eleciawhite/FeedThing/hardware/boostResistorRemoval.jpg

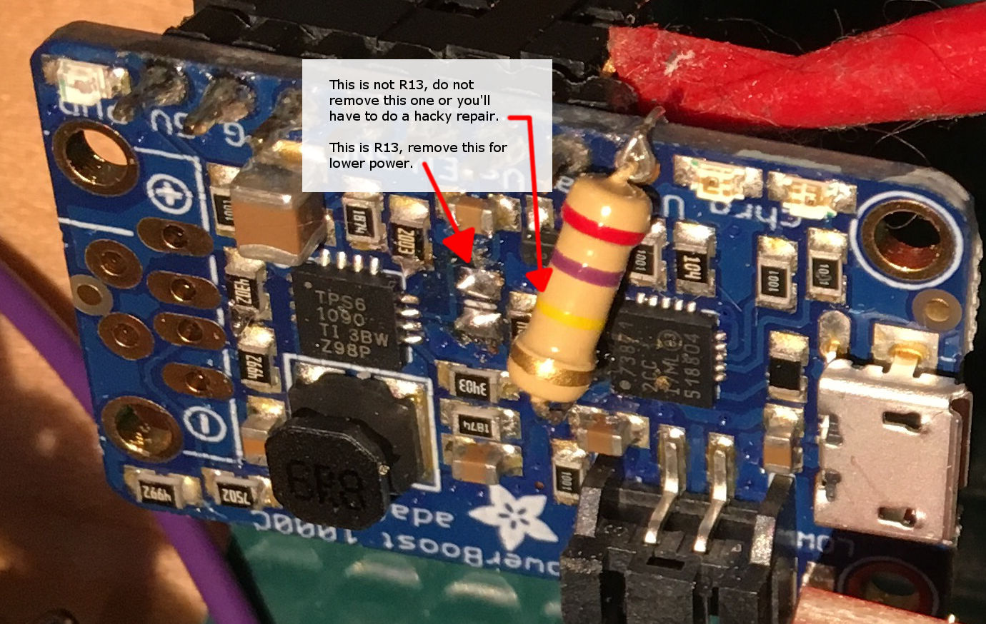
hardware/boostResistorRemoval.jpg
