eleciawhite/FeedThing/hardware/bom.xlsx

Item | Vendor | Price | Notes | Link
Thing | Sparkfun | $16 |  | https://www.sparkfun.com/products/13231
Photo interrupter | Sparkfun | $2 |  | https://www.sparkfun.com/products/9299
Photo interrupter board | Sparkfun | $1.50 | The resistor needs to be 1k as we are using a 3.3V power source | https://www.sparkfun.com/products/9322
Power boost | Adafruit | $20 | The 500C version also works, probably should switch to it | https://www.adafruit.com/products/2465
Motor board (Arduino v2) | Adafruit | $20 | This must be in switch to 3V mode | https://www.adafruit.com/product/1438
Motor | Adafruit | $5 |  | https://www.adafruit.com/products/858
LiPo battery | Adafruit | $29.50 | 6600mAh | https://www.adafruit.com/products/353
NPN BJT transistor | Sparkfun | $0.50 |  | https://www.sparkfun.com/products/521
10k Resistors | Sparkfun | $0.95 | This is a pack of all 10ks, anything large-ish and matched is fine. | https://www.sparkfun.com/products/11508
1k Resistor | Sparkfun | $0.25 | This is a single 1k, could do better to buy an assorted pack. | https://www.sparkfun.com/products/8980
Note: I'm not listing the header pins or jumper wires here, you may need some if you don't already have a pack
Not yet integrated but likely needed:
Power button | Adafruit | $5 |  | https://www.adafruit.com/products/482
