eleciawhite/FeedThing/hardware/FeedThingWiring.jpg

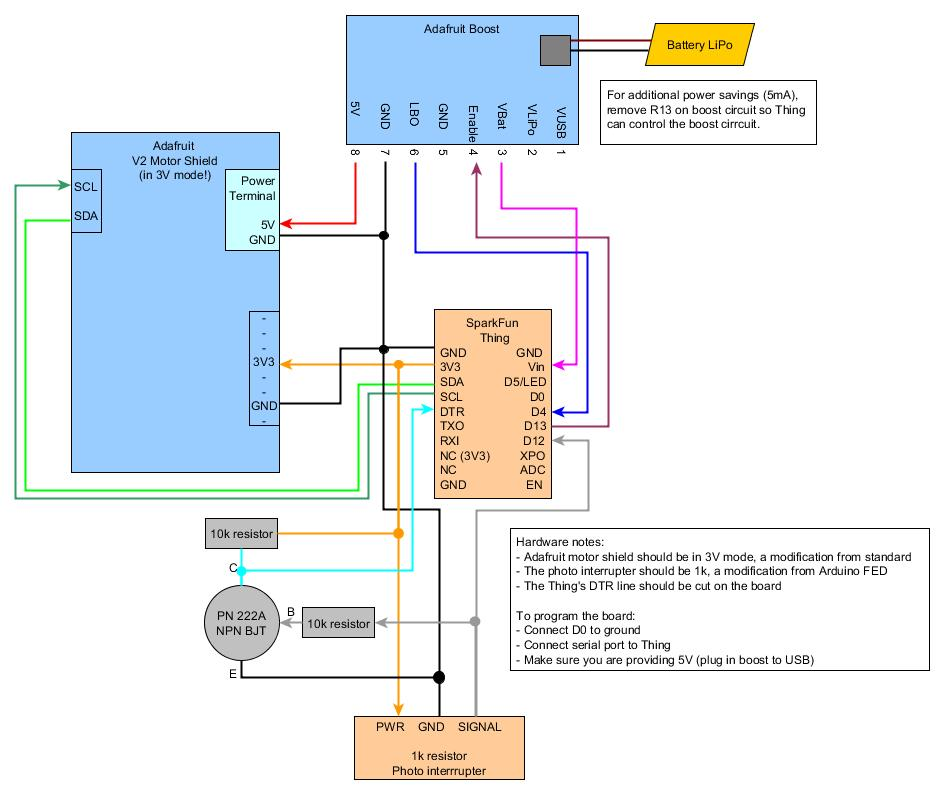
hardware/FeedThingWiring.jpg
