eleciawhite/FeedThing/FeedThingSketch/wifiPassword.h

// This is where you store your WiFi definition. They should be
// private to your project, not shared with others.
// 
// Fill in WiFiSSID with the WiFi network name and the
// WiFiPSK with the password.

const char WiFiSSID[] = "Your WiFi name";
const char WiFiPSK[] = "Your WiFi password";
