eleciawhite/FeedThing/(commit log)

2015-10-22 Initial commit of FeedThing, fails to sleep at this point and no good description of the hardware.
    [bom.xlsx]
2015-10-26 Added boost turn on and off, redid some pins. Function-ized some. System goes to sleep but does not wake up with photo interrupter at this time (it does wake up with timer but that is set to once an 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
    [bom.xlsx]
2015-10-26 Adding a wiring diagram
2015-11-06 Added transistor to make photo interrupter able to wake up Thing
2015-11-07 Higher res boost schematic, photo of which resistor to remove for power savings. Added motor shield's main chip and updated Adafruit code to put motor into sleep state (saving 3mA) Updated FeedThingS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
    [bom.xlsx]
2015-11-09 Updating wiring jpg to show power savings
2023-03-14 Removed Curves, added Chicken Wire, Yoshimura, Miura and Miura Shifting.
